s0rryFSU/waterpumpproject/README.md

#### Automated Water Pump Project

## File contains:
* Python file
* Hex file
* Top and bottom STL files for housing model
* Final Project Submission
