s0rryFSU/waterpumpproject/ece 2021 - milestone - printprep v2 - top and access.stl

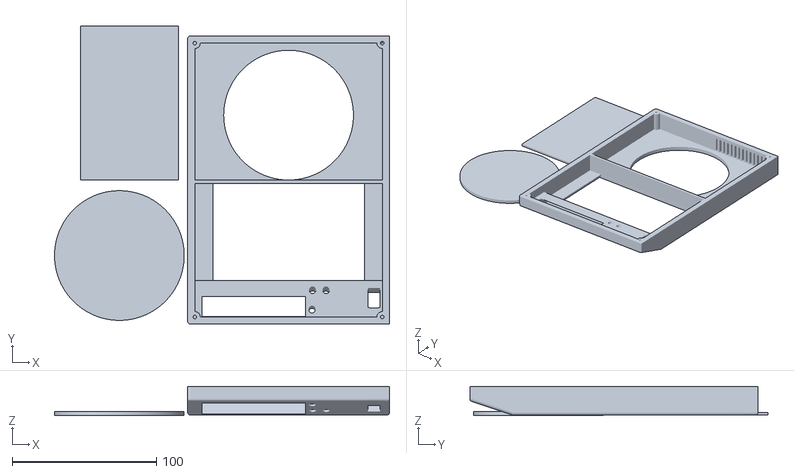
[picture p10: CAD file, 2024-05-01]
ece 2021 - milestone - printprep v2 - top and access.stl
232.4 x 207.0 x 20.3
