s0rryFSU/waterpumpproject/ece 2021 - milestone - printprep v2 - bottom.stl

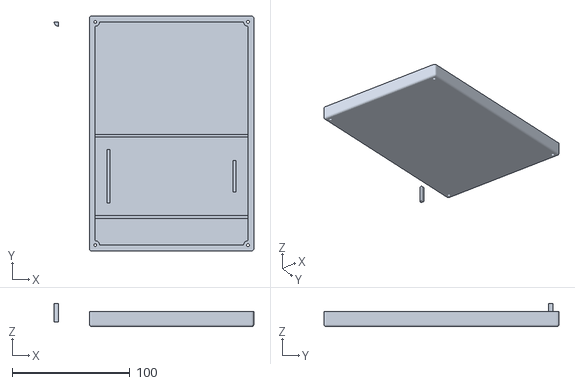
[picture p11: CAD file, 2024-05-01]
ece 2021 - milestone - printprep v2 - bottom.stl
170.0 x 200.0 x 20.0
